RadaanK/Fischertechnik_Factory_IBM/int-connected-factory-master/Source_Code/Node_RED_Visual_Inspection/Readme_Images/Picture_of_Setup.jpg

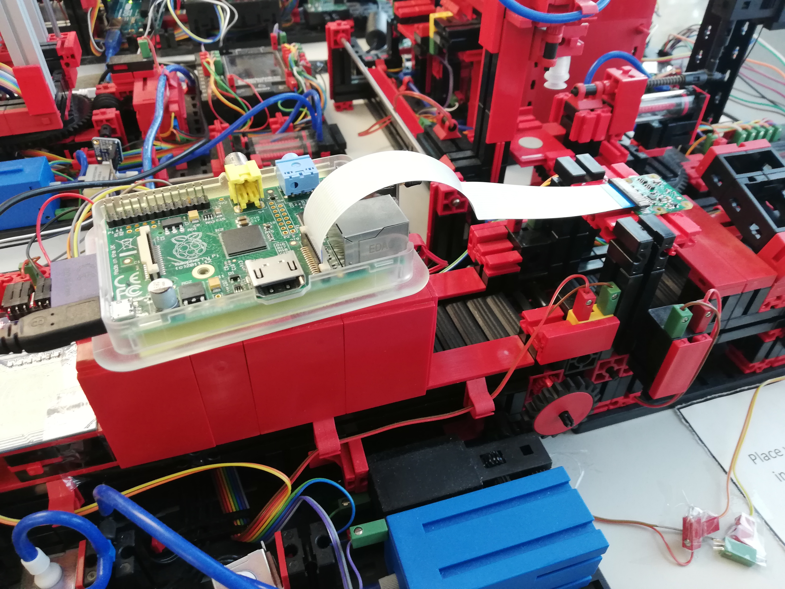
int-connected-factory-master/Source_Code/Node_RED_Visual_Inspection/Readme_Images/Picture_of_Setup.jpg
