RadaanK/Fischertechnik_Factory_IBM/int-connected-factory-master/Source_Code/Visual_Recognition/Images/Red_With_Scratch/pic_5ae9167f-bc9a-462e-9c37-ad97ae4d3c14.jpg

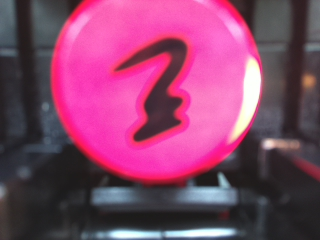
int-connected-factory-master/Source_Code/Visual_Recognition/Images/Red_With_Scratch/pic_5ae9167f-bc9a-462e-9c37-ad97ae4d3c14.jpg
