RadaanK/Fischertechnik_Factory_IBM/int-connected-factory-master/README.md

# Fischertechnik_Munich
This repo contains the code for the Fischertechnik plant at the 24th floor of the Munich IoT Centre.

# Foto
foto_of_plant
