RadaanK/Fischertechnik_Factory_IBM/int-connected-factory-master/Documents/Documents Fischertechnik/Readme.md

# Readme

This folder contains some documets about the different components delivered by Fischertechnik.
Some documents describe the used modules (warehouse, vaccum gripper, sorting line and processing station).
Others describe some individual parts (e.g. motor)
