RadaanK/Fischertechnik_Factory_IBM/int-connected-factory-master/Source_Code/Node_RED_Raspberry_Pi/Readme.md

# Readme

This folder contains the code for the Node-RED instance running on the Raspberry Pi 
(the one responible for the communication between the Arduinos and the IBM IoT platform).
First Node-RED has to be installed on the Raspberry Pi (https://nodered.org/docs/getting-started/raspberrypi).
Then the Json file can be imported as shown in the following picture: 
how_to_import
