RadaanK/Fischertechnik_Factory_IBM/int-connected-factory-master/Documents/QR_Code to access the Slack chatbot.docx

Get access to the chatbot in Slack:

- Search for “Fischertechnik Chatbot” in the GBS Watson IoT Practice Munich workspace
- Or scan this QR code:

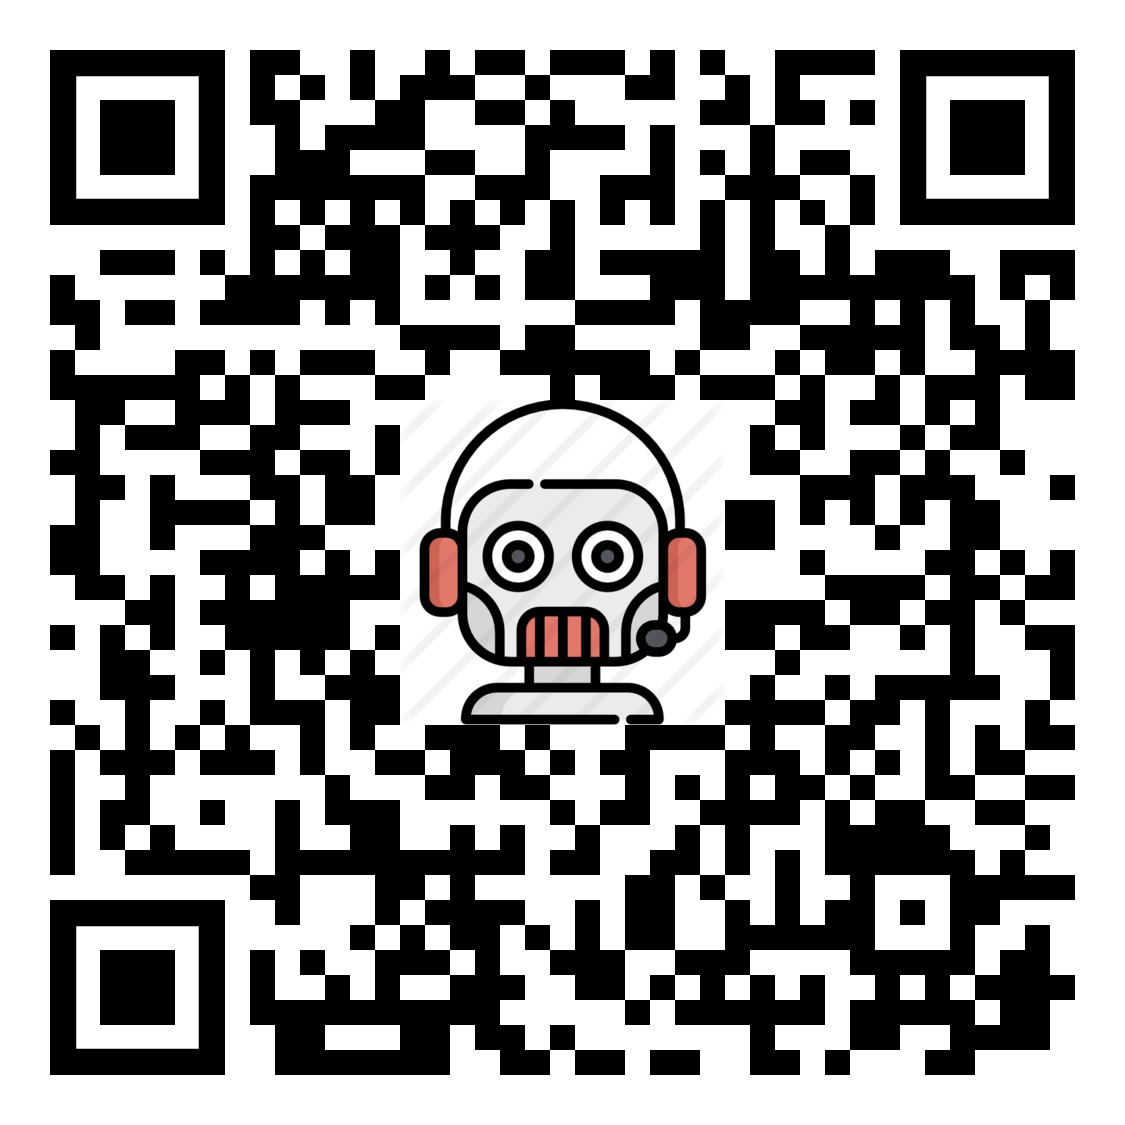
[picture p3: figure]
