RadaanK/Fischertechnik_Factory_IBM/int-connected-factory-master/Documents/Architecture/Architecture.png

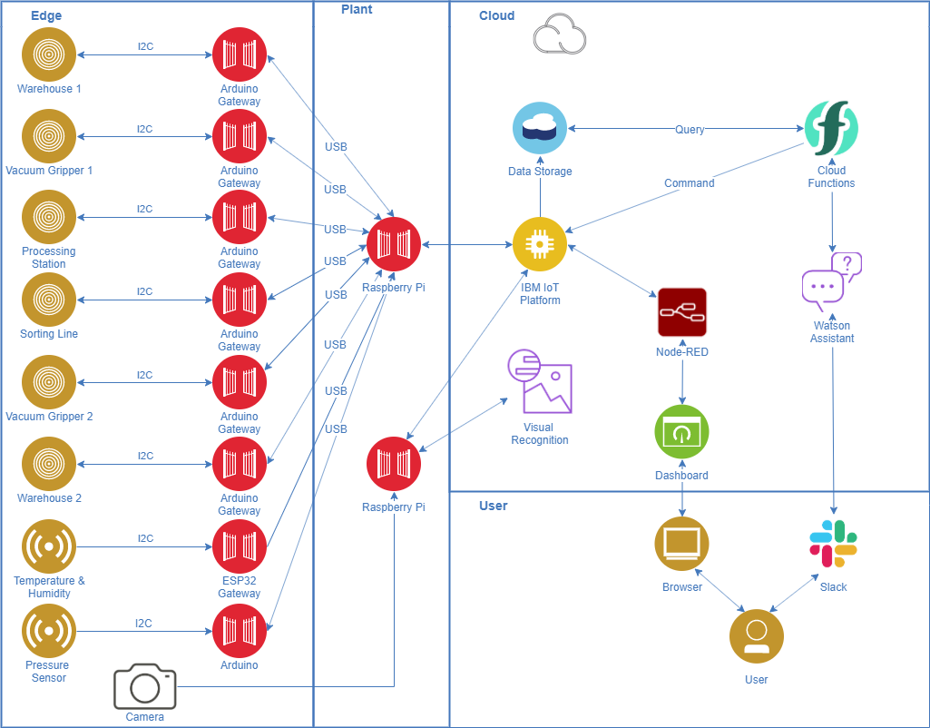
int-connected-factory-master/Documents/Architecture/Architecture.png
