RadaanK/Fischertechnik_Factory_IBM/int-connected-factory-master/Documents/Story/Story/IMG_20190731_112832.jpg

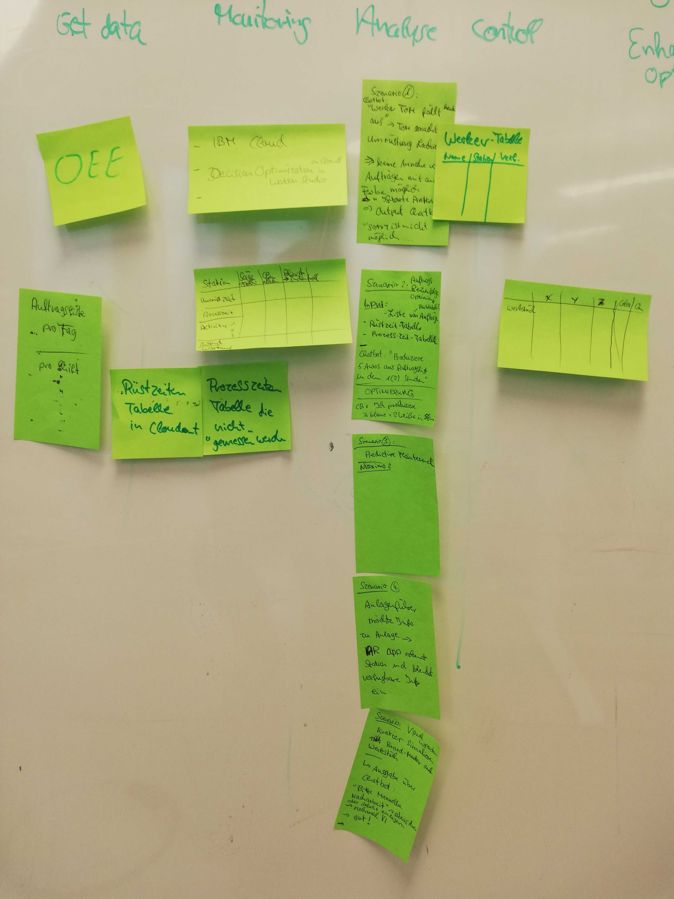
int-connected-factory-master/Documents/Story/Story/IMG_20190731_112832.jpg
