RadaanK/Fischertechnik_Factory_IBM/int-connected-factory-master/Documents/Story/Story/Scenarios/Szenario_5_Pressure_Sensor/Images/Figure 3.png

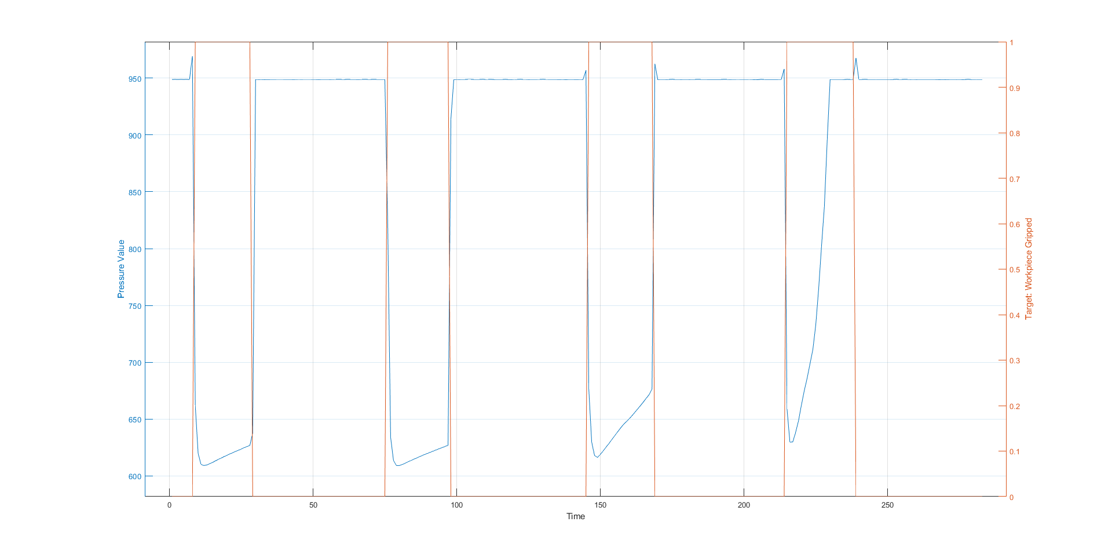
int-connected-factory-master/Documents/Story/Story/Scenarios/Szenario_5_Pressure_Sensor/Images/Figure 3.png
