RadaanK/Fischertechnik_Factory_IBM/int-connected-factory-master/Readme_Images/Foto_of_plant.jpg

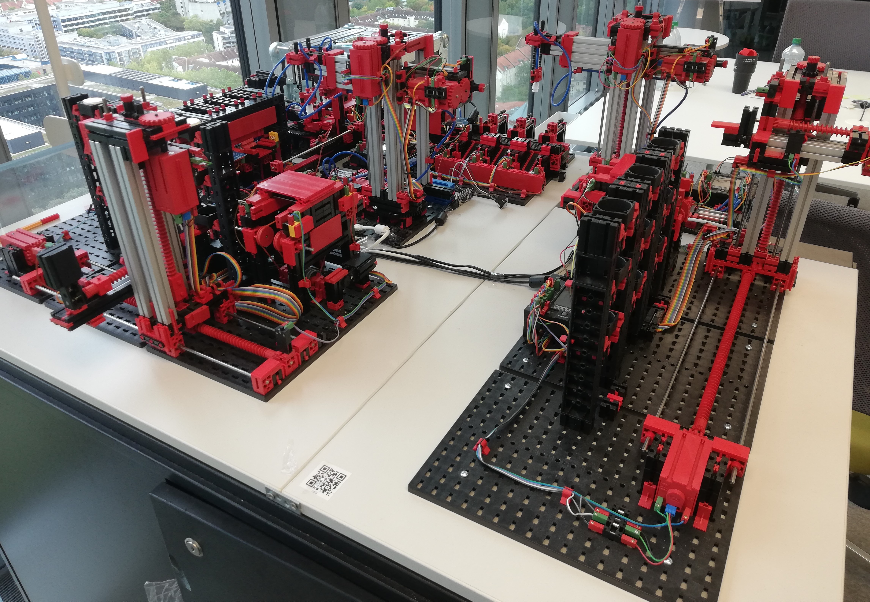
int-connected-factory-master/Readme_Images/Foto_of_plant.jpg
