RadaanK/Fischertechnik_Factory_IBM/int-connected-factory-master/Source_Code/Arduino/Readme_Images/Cabeling_Arduino_Uno.jpg

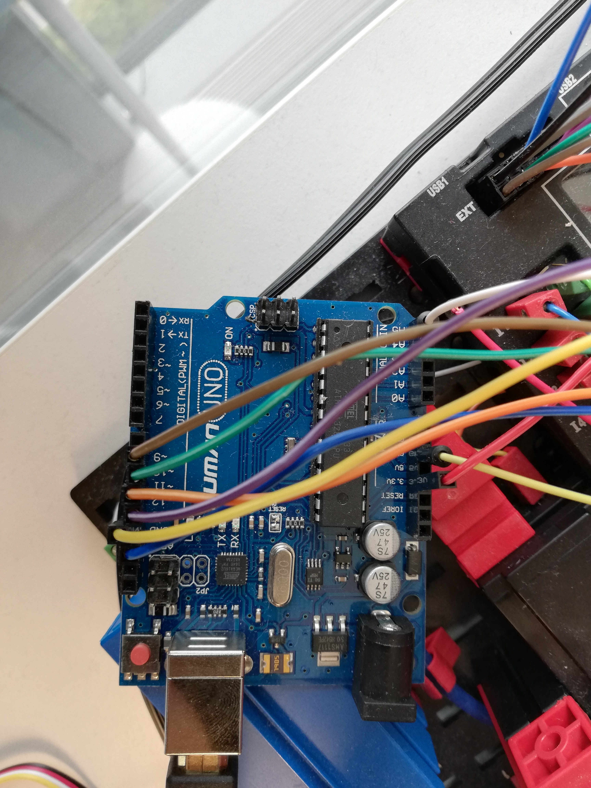
int-connected-factory-master/Source_Code/Arduino/Readme_Images/Cabeling_Arduino_Uno.jpg
