RadaanK/Fischertechnik_Factory_IBM/int-connected-factory-master/Source_Code/Arduino/Readme_Images/Cabeling_NFC_Reader.jpg

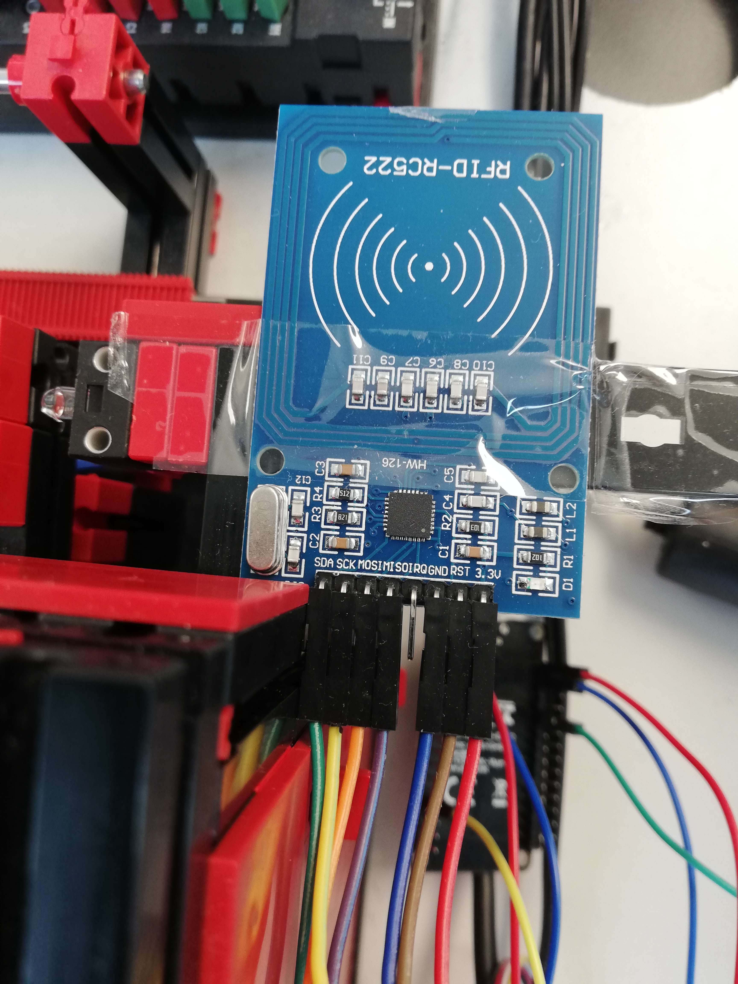
int-connected-factory-master/Source_Code/Arduino/Readme_Images/Cabeling_NFC_Reader.jpg
