RadaanK/Fischertechnik_Factory_IBM/int-connected-factory-master/Source_Code/Arduino/Readme_Images/Controller_Pin_Assignment.PNG

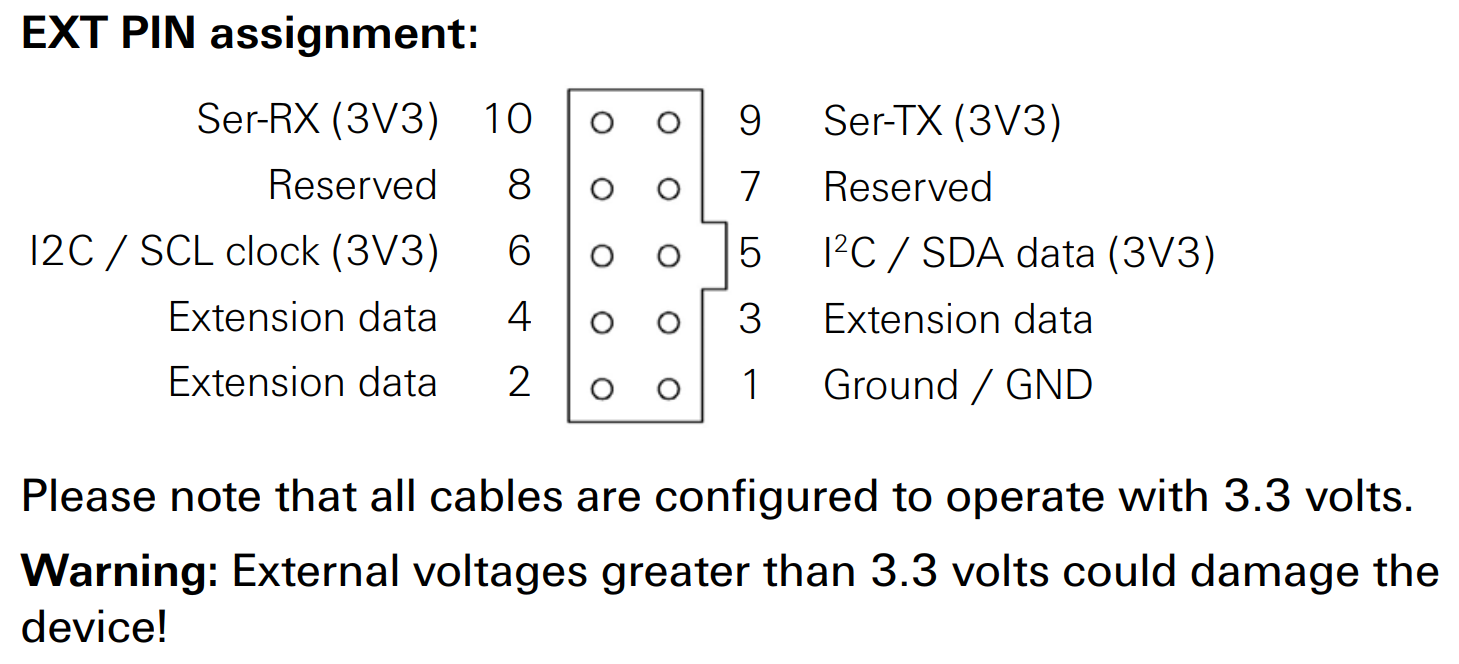
int-connected-factory-master/Source_Code/Arduino/Readme_Images/Controller_Pin_Assignment.PNG
