RadaanK/Fischertechnik_Factory_IBM/int-connected-factory-master/Source_Code/Cloud_Functions/Images_Readme/Cloud_Functions_1.png

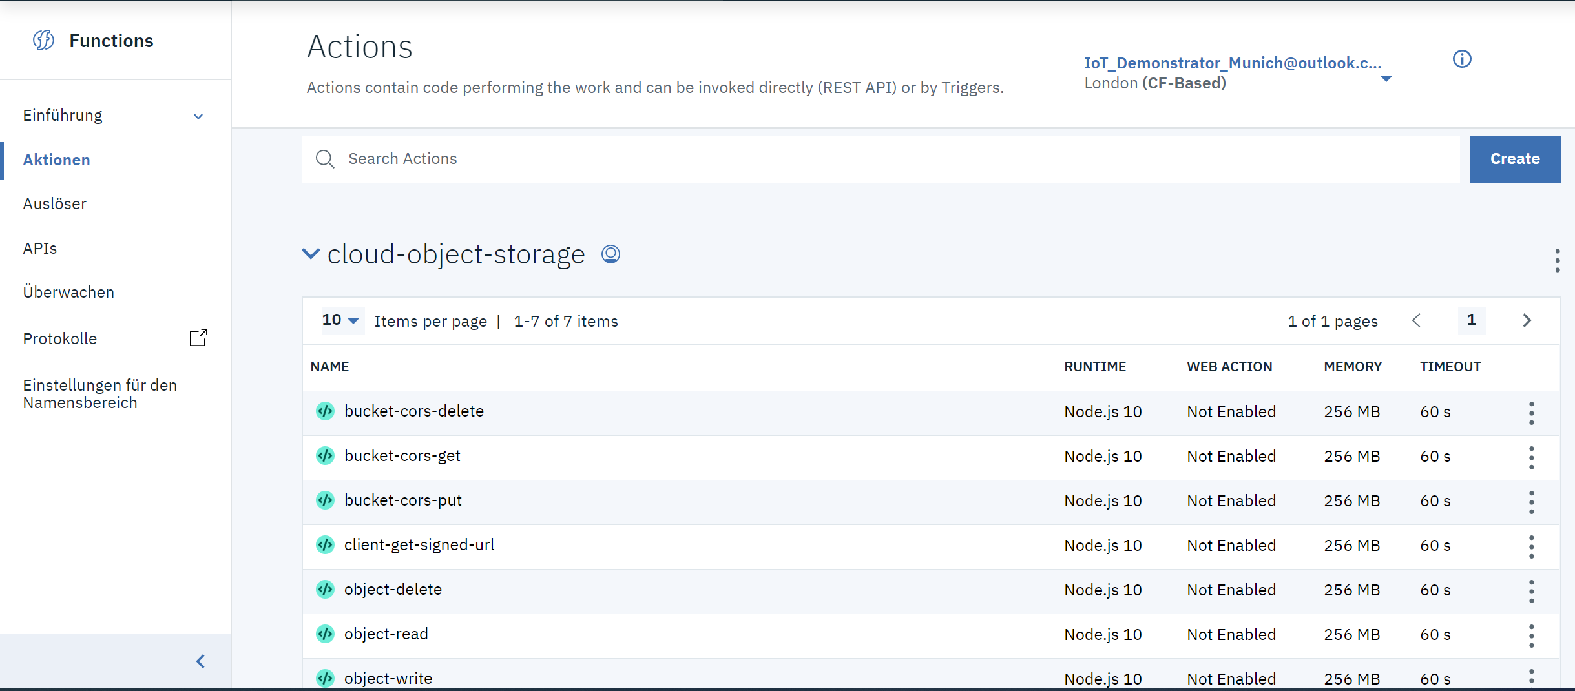
int-connected-factory-master/Source_Code/Cloud_Functions/Images_Readme/Cloud_Functions_1.png
