RadaanK/Fischertechnik_Factory_IBM/int-connected-factory-master/Source_Code/Visual_Recognition/Images/Blue_With_Scratch/pic_6ee05822-eb01-4ae4-a5b6-be8dfba36813.jpg

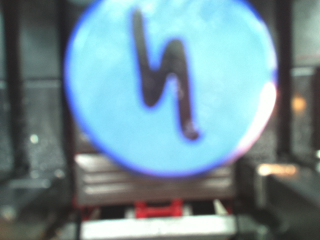
int-connected-factory-master/Source_Code/Visual_Recognition/Images/Blue_With_Scratch/pic_6ee05822-eb01-4ae4-a5b6-be8dfba36813.jpg
