RadaanK/Fischertechnik_Factory_IBM/int-connected-factory-master/Source_Code/Visual_Recognition/Images/Blue_With_Scratch/pic_44ba1a00-57a2-4b40-8c53-b260515f05a0.jpg

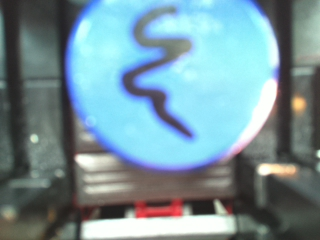
int-connected-factory-master/Source_Code/Visual_Recognition/Images/Blue_With_Scratch/pic_44ba1a00-57a2-4b40-8c53-b260515f05a0.jpg
