RadaanK/Fischertechnik_Factory_IBM/int-connected-factory-master/Source_Code/Visual_Recognition/Images/Blue_With_Scratch/pic_60d750b2-c480-4060-b84b-7900d25849db.jpg

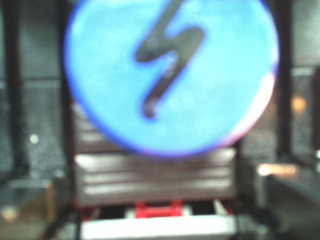
int-connected-factory-master/Source_Code/Visual_Recognition/Images/Blue_With_Scratch/pic_60d750b2-c480-4060-b84b-7900d25849db.jpg
