RadaanK/Fischertechnik_Factory_IBM/int-connected-factory-master/Source_Code/Visual_Recognition/Images/Blue_With_Scratch/pic_257f01ea-9b48-4399-9710-3b7ceee71c3d.jpg

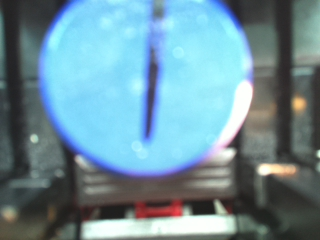
int-connected-factory-master/Source_Code/Visual_Recognition/Images/Blue_With_Scratch/pic_257f01ea-9b48-4399-9710-3b7ceee71c3d.jpg
