RadaanK/Fischertechnik_Factory_IBM/int-connected-factory-master/Source_Code/Visual_Recognition/Images/Blue_With_Scratch/pic_585baca4-2b5c-4661-a3ae-9914493b79fe.jpg

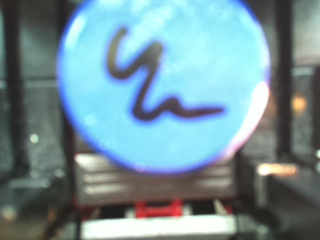
int-connected-factory-master/Source_Code/Visual_Recognition/Images/Blue_With_Scratch/pic_585baca4-2b5c-4661-a3ae-9914493b79fe.jpg
