RadaanK/Fischertechnik_Factory_IBM/int-connected-factory-master/Source_Code/Visual_Recognition/Images/Blue_With_Scratch/pic_4958c0a8-0177-4b15-a33d-297569485a4a.jpg

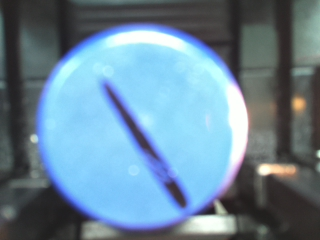
int-connected-factory-master/Source_Code/Visual_Recognition/Images/Blue_With_Scratch/pic_4958c0a8-0177-4b15-a33d-297569485a4a.jpg
