RadaanK/Fischertechnik_Factory_IBM/int-connected-factory-master/Source_Code/Visual_Recognition/Images/Blue_With_Scratch/pic_7865c3a0-ef06-42df-8c5a-3ec4aaaf4b60.jpg

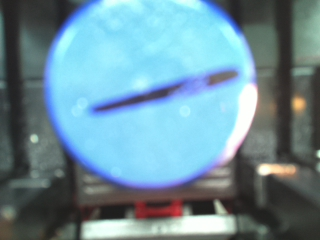
int-connected-factory-master/Source_Code/Visual_Recognition/Images/Blue_With_Scratch/pic_7865c3a0-ef06-42df-8c5a-3ec4aaaf4b60.jpg
