RadaanK/Fischertechnik_Factory_IBM/int-connected-factory-master/Source_Code/Visual_Recognition/Images/Blue_With_Scratch/pic_92756736-0fad-4278-b8e0-99494414e42e.jpg

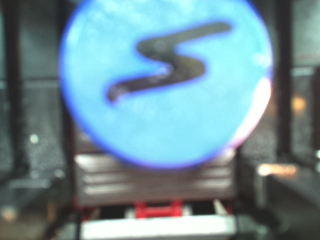
int-connected-factory-master/Source_Code/Visual_Recognition/Images/Blue_With_Scratch/pic_92756736-0fad-4278-b8e0-99494414e42e.jpg
