RadaanK/Fischertechnik_Factory_IBM/int-connected-factory-master/Source_Code/Visual_Recognition/Images/Blue_With_Scratch/pic_a7a9ee02-e9d2-4ce0-b42a-490beab9bbe5.jpg

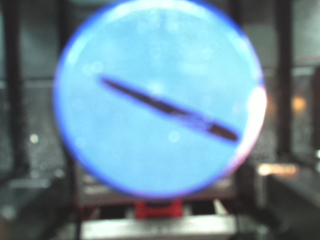
int-connected-factory-master/Source_Code/Visual_Recognition/Images/Blue_With_Scratch/pic_a7a9ee02-e9d2-4ce0-b42a-490beab9bbe5.jpg
