RadaanK/Fischertechnik_Factory_IBM/int-connected-factory-master/Source_Code/Visual_Recognition/Images/Blue_With_Scratch/pic_bf9dd142-1b95-439f-b088-64bb233a1e68.jpg

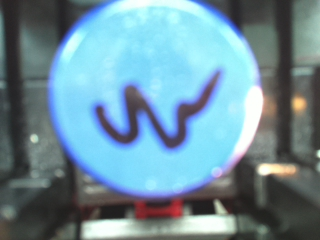
int-connected-factory-master/Source_Code/Visual_Recognition/Images/Blue_With_Scratch/pic_bf9dd142-1b95-439f-b088-64bb233a1e68.jpg
