RadaanK/Fischertechnik_Factory_IBM/int-connected-factory-master/Source_Code/Visual_Recognition/Images/Blue_With_Scratch/pic_d63db4d3-26aa-41d6-b190-c1351fe853c5.jpg

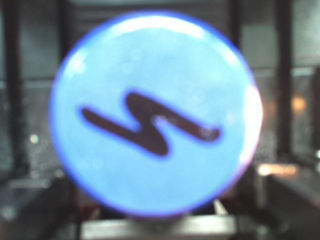
int-connected-factory-master/Source_Code/Visual_Recognition/Images/Blue_With_Scratch/pic_d63db4d3-26aa-41d6-b190-c1351fe853c5.jpg
