RadaanK/Fischertechnik_Factory_IBM/int-connected-factory-master/Source_Code/Visual_Recognition/Images/Blue_With_Scratch/pic_f52674f7-41e7-4f9a-8e8a-8ba461ca570b.jpg

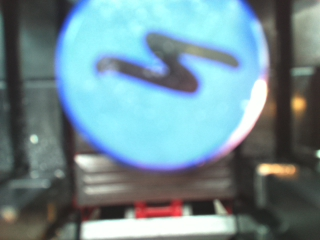
int-connected-factory-master/Source_Code/Visual_Recognition/Images/Blue_With_Scratch/pic_f52674f7-41e7-4f9a-8e8a-8ba461ca570b.jpg
