RadaanK/Fischertechnik_Factory_IBM/int-connected-factory-master/Source_Code/Visual_Recognition/Images/Blue_With_Scratch/pic_ff827206-aa92-4c91-befb-8f4d27b9cf81.jpg

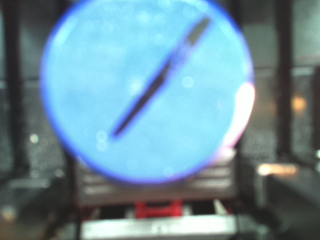
int-connected-factory-master/Source_Code/Visual_Recognition/Images/Blue_With_Scratch/pic_ff827206-aa92-4c91-befb-8f4d27b9cf81.jpg
