RadaanK/Fischertechnik_Factory_IBM/int-connected-factory-master/Source_Code/Visual_Recognition/Images/Blue_Without_Scratch/pic_2bd5c420-6e2a-474f-995c-3f01320a25c1.jpg

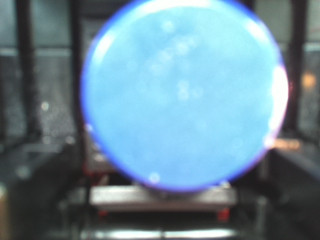
int-connected-factory-master/Source_Code/Visual_Recognition/Images/Blue_Without_Scratch/pic_2bd5c420-6e2a-474f-995c-3f01320a25c1.jpg
