RadaanK/Fischertechnik_Factory_IBM/int-connected-factory-master/Source_Code/Visual_Recognition/Images/Blue_Without_Scratch/pic_03bd9a95-2f23-43ee-b81c-bd671a089540.jpg

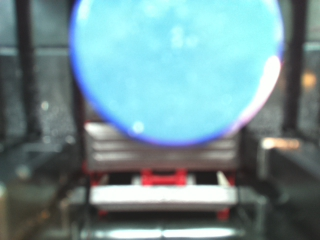
int-connected-factory-master/Source_Code/Visual_Recognition/Images/Blue_Without_Scratch/pic_03bd9a95-2f23-43ee-b81c-bd671a089540.jpg
