RadaanK/Fischertechnik_Factory_IBM/int-connected-factory-master/Source_Code/Visual_Recognition/Images/Blue_Without_Scratch/pic_6b2f1941-4130-4e85-a551-bb04257c04fe.jpg

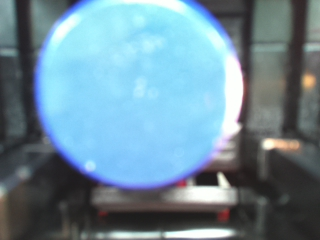
int-connected-factory-master/Source_Code/Visual_Recognition/Images/Blue_Without_Scratch/pic_6b2f1941-4130-4e85-a551-bb04257c04fe.jpg
