RadaanK/Fischertechnik_Factory_IBM/int-connected-factory-master/Source_Code/Visual_Recognition/Images/Blue_Without_Scratch/pic_8d54d213-2766-4aaa-8784-aa275ecdaccd.jpg

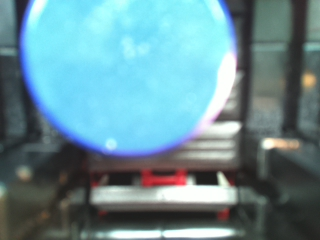
int-connected-factory-master/Source_Code/Visual_Recognition/Images/Blue_Without_Scratch/pic_8d54d213-2766-4aaa-8784-aa275ecdaccd.jpg
