RadaanK/Fischertechnik_Factory_IBM/int-connected-factory-master/Source_Code/Visual_Recognition/Images/Blue_Without_Scratch/pic_16edd78b-cffc-4e18-be51-fe0cdaa5b705.jpg

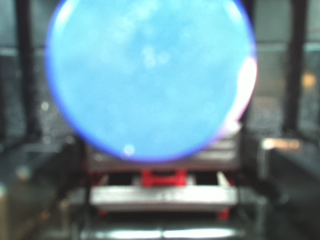
int-connected-factory-master/Source_Code/Visual_Recognition/Images/Blue_Without_Scratch/pic_16edd78b-cffc-4e18-be51-fe0cdaa5b705.jpg
