RadaanK/Fischertechnik_Factory_IBM/int-connected-factory-master/Source_Code/Visual_Recognition/Images/Blue_Without_Scratch/pic_100e419a-90d1-41c0-990e-5b7522d13269.jpg

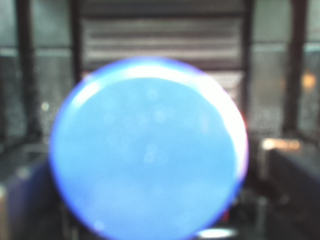
int-connected-factory-master/Source_Code/Visual_Recognition/Images/Blue_Without_Scratch/pic_100e419a-90d1-41c0-990e-5b7522d13269.jpg
