RadaanK/Fischertechnik_Factory_IBM/int-connected-factory-master/Source_Code/Visual_Recognition/Images/Blue_Without_Scratch/pic_443fc9e2-942e-4b88-b6fd-92f85d25942b.jpg

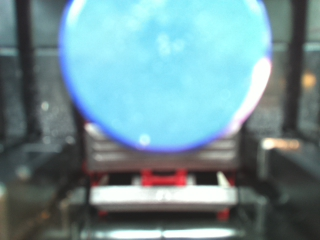
int-connected-factory-master/Source_Code/Visual_Recognition/Images/Blue_Without_Scratch/pic_443fc9e2-942e-4b88-b6fd-92f85d25942b.jpg
