RadaanK/Fischertechnik_Factory_IBM/int-connected-factory-master/Source_Code/Visual_Recognition/Images/Blue_Without_Scratch/pic_a1e88f21-aa5b-4406-b35d-a229cc25c989.jpg

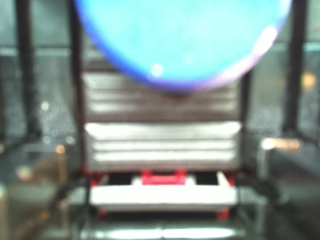
int-connected-factory-master/Source_Code/Visual_Recognition/Images/Blue_Without_Scratch/pic_a1e88f21-aa5b-4406-b35d-a229cc25c989.jpg
