RadaanK/Fischertechnik_Factory_IBM/int-connected-factory-master/Source_Code/Visual_Recognition/Images/Blue_Without_Scratch/pic_c731b44b-4198-4752-98b8-99e775d03f8e.jpg

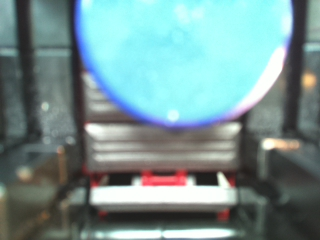
int-connected-factory-master/Source_Code/Visual_Recognition/Images/Blue_Without_Scratch/pic_c731b44b-4198-4752-98b8-99e775d03f8e.jpg
