RadaanK/Fischertechnik_Factory_IBM/int-connected-factory-master/Source_Code/Visual_Recognition/Images/Blue_Without_Scratch/pic_f74e6497-be4d-4806-879b-3bc070af202e.jpg

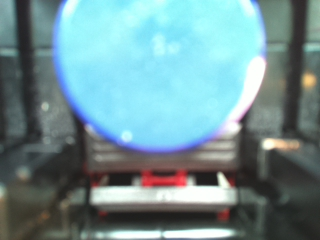
int-connected-factory-master/Source_Code/Visual_Recognition/Images/Blue_Without_Scratch/pic_f74e6497-be4d-4806-879b-3bc070af202e.jpg
