RadaanK/Fischertechnik_Factory_IBM/int-connected-factory-master/Source_Code/Visual_Recognition/Images/No_Workpiece/pic_7c79bbad-e781-4910-84c2-cd3412517aed.jpg

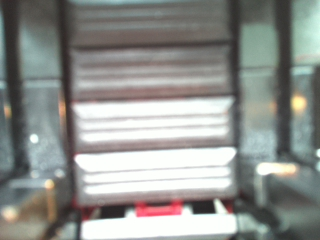
int-connected-factory-master/Source_Code/Visual_Recognition/Images/No_Workpiece/pic_7c79bbad-e781-4910-84c2-cd3412517aed.jpg
