RadaanK/Fischertechnik_Factory_IBM/int-connected-factory-master/Source_Code/Visual_Recognition/Images/No_Workpiece/pic_5428665c-1ac8-4c36-be89-cd5b3be53e2c.jpg

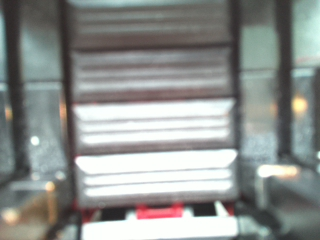
int-connected-factory-master/Source_Code/Visual_Recognition/Images/No_Workpiece/pic_5428665c-1ac8-4c36-be89-cd5b3be53e2c.jpg
