RadaanK/Fischertechnik_Factory_IBM/int-connected-factory-master/Source_Code/Visual_Recognition/Images/No_Workpiece/pic_43159170-60e4-4133-8779-5aea9031d7ec.jpg

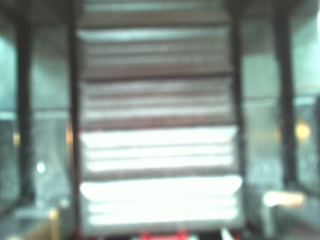
int-connected-factory-master/Source_Code/Visual_Recognition/Images/No_Workpiece/pic_43159170-60e4-4133-8779-5aea9031d7ec.jpg
