RadaanK/Fischertechnik_Factory_IBM/int-connected-factory-master/Source_Code/Visual_Recognition/Images/Red_With_Scratch/pic_1fc5a1ba-6591-4306-b836-01b4095cde05.jpg

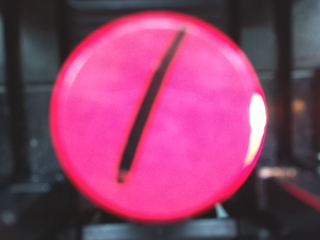
int-connected-factory-master/Source_Code/Visual_Recognition/Images/Red_With_Scratch/pic_1fc5a1ba-6591-4306-b836-01b4095cde05.jpg
