RadaanK/Fischertechnik_Factory_IBM/int-connected-factory-master/Source_Code/Visual_Recognition/Images/Red_With_Scratch/pic_6c0c605b-86db-4a4c-b3e3-3497d2ecde54.jpg

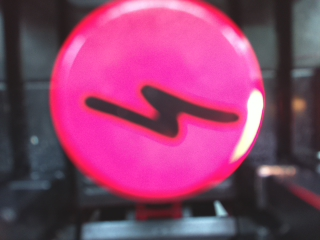
int-connected-factory-master/Source_Code/Visual_Recognition/Images/Red_With_Scratch/pic_6c0c605b-86db-4a4c-b3e3-3497d2ecde54.jpg
