RadaanK/Fischertechnik_Factory_IBM/int-connected-factory-master/Source_Code/Visual_Recognition/Images/Red_With_Scratch/pic_49e84ed8-d9ab-4422-9b6c-5a36736f64b0.jpg

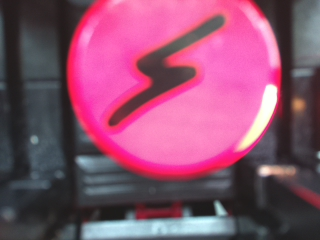
int-connected-factory-master/Source_Code/Visual_Recognition/Images/Red_With_Scratch/pic_49e84ed8-d9ab-4422-9b6c-5a36736f64b0.jpg
