RadaanK/Fischertechnik_Factory_IBM/int-connected-factory-master/Source_Code/Visual_Recognition/Images/Red_With_Scratch/pic_902d0cdd-8ce4-48a2-b398-864d60b77477.jpg

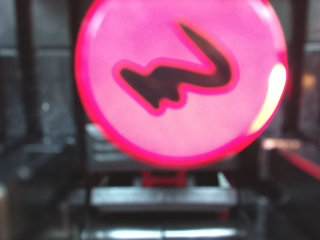
int-connected-factory-master/Source_Code/Visual_Recognition/Images/Red_With_Scratch/pic_902d0cdd-8ce4-48a2-b398-864d60b77477.jpg
