RadaanK/Fischertechnik_Factory_IBM/int-connected-factory-master/Source_Code/Visual_Recognition/Images/Red_With_Scratch/pic_912b4482-c928-4562-92a2-9c388088ef4c.jpg

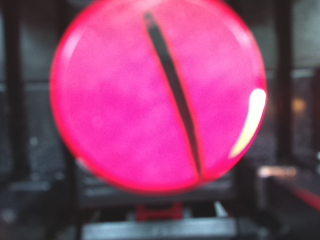
int-connected-factory-master/Source_Code/Visual_Recognition/Images/Red_With_Scratch/pic_912b4482-c928-4562-92a2-9c388088ef4c.jpg
