RadaanK/Fischertechnik_Factory_IBM/int-connected-factory-master/Source_Code/Visual_Recognition/Images/Red_With_Scratch/pic_966dfb1d-3ee6-43b8-9916-991be9dda959.jpg

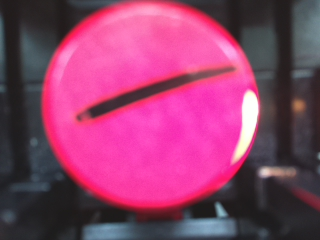
int-connected-factory-master/Source_Code/Visual_Recognition/Images/Red_With_Scratch/pic_966dfb1d-3ee6-43b8-9916-991be9dda959.jpg
