RadaanK/Fischertechnik_Factory_IBM/int-connected-factory-master/Source_Code/Visual_Recognition/Images/Red_With_Scratch/pic_2315ad4b-5ecf-494b-81a8-4649002291f0.jpg

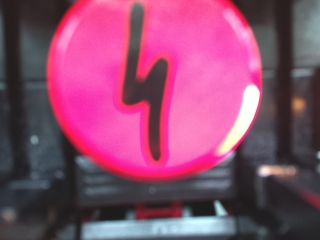
int-connected-factory-master/Source_Code/Visual_Recognition/Images/Red_With_Scratch/pic_2315ad4b-5ecf-494b-81a8-4649002291f0.jpg
