RadaanK/Fischertechnik_Factory_IBM/int-connected-factory-master/Source_Code/Visual_Recognition/Images/Red_With_Scratch/pic_7496dad8-e732-4b92-aa2e-0782ee8b002e.jpg

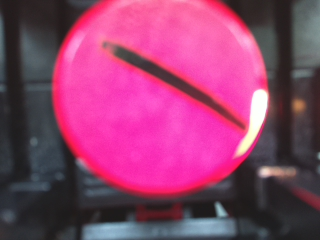
int-connected-factory-master/Source_Code/Visual_Recognition/Images/Red_With_Scratch/pic_7496dad8-e732-4b92-aa2e-0782ee8b002e.jpg
