RadaanK/Fischertechnik_Factory_IBM/int-connected-factory-master/Source_Code/Visual_Recognition/Images/Red_With_Scratch/pic_159555d0-30fc-4e93-9c4b-e4c3b19fbac0.jpg

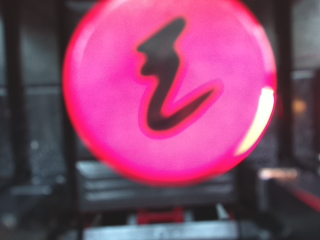
int-connected-factory-master/Source_Code/Visual_Recognition/Images/Red_With_Scratch/pic_159555d0-30fc-4e93-9c4b-e4c3b19fbac0.jpg
