RadaanK/Fischertechnik_Factory_IBM/int-connected-factory-master/Source_Code/Visual_Recognition/Images/Red_With_Scratch/pic_a941a2e0-b87a-4e30-942a-0a5fac9722af.jpg

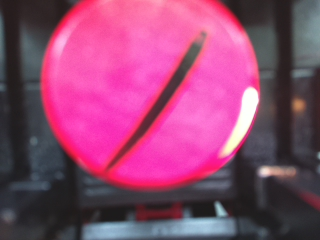
int-connected-factory-master/Source_Code/Visual_Recognition/Images/Red_With_Scratch/pic_a941a2e0-b87a-4e30-942a-0a5fac9722af.jpg
