RadaanK/Fischertechnik_Factory_IBM/int-connected-factory-master/Source_Code/Visual_Recognition/Images/Red_With_Scratch/pic_e6fc505e-8fb1-4975-84c8-51584e118ead.jpg

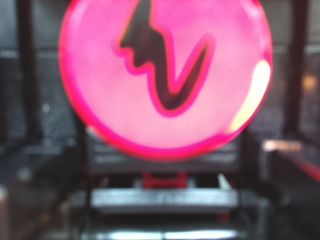
int-connected-factory-master/Source_Code/Visual_Recognition/Images/Red_With_Scratch/pic_e6fc505e-8fb1-4975-84c8-51584e118ead.jpg
