RadaanK/Fischertechnik_Factory_IBM/int-connected-factory-master/Source_Code/Visual_Recognition/Images/Red_With_Scratch/pic_f9133105-80e1-4a96-8cf9-9a1a2191820e.jpg

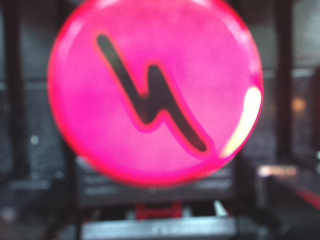
int-connected-factory-master/Source_Code/Visual_Recognition/Images/Red_With_Scratch/pic_f9133105-80e1-4a96-8cf9-9a1a2191820e.jpg
