RadaanK/Fischertechnik_Factory_IBM/int-connected-factory-master/Source_Code/Visual_Recognition/Images/Red_With_Scratch/pic_fe8fce01-5d8d-494c-98e0-f4d57ea840aa.jpg

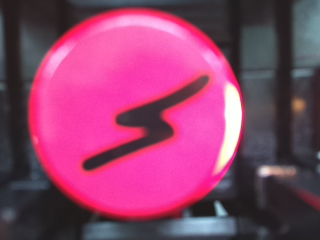
int-connected-factory-master/Source_Code/Visual_Recognition/Images/Red_With_Scratch/pic_fe8fce01-5d8d-494c-98e0-f4d57ea840aa.jpg
