RadaanK/Fischertechnik_Factory_IBM/int-connected-factory-master/Source_Code/Visual_Recognition/Images/Red_Without_Scratch/pic_3f4c9419-3676-4ad7-bed3-490422fa68b0.jpg

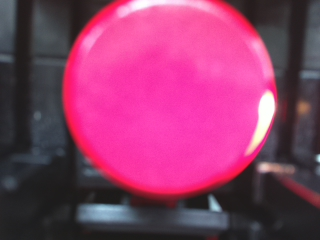
int-connected-factory-master/Source_Code/Visual_Recognition/Images/Red_Without_Scratch/pic_3f4c9419-3676-4ad7-bed3-490422fa68b0.jpg
