RadaanK/Fischertechnik_Factory_IBM/int-connected-factory-master/Source_Code/Visual_Recognition/Images/Red_Without_Scratch/pic_7ddf3377-bf2f-4b33-bc89-32006f9bbcb6.jpg

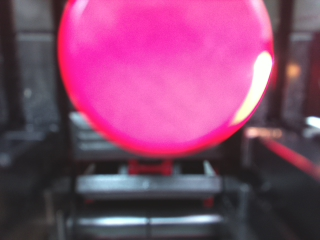
int-connected-factory-master/Source_Code/Visual_Recognition/Images/Red_Without_Scratch/pic_7ddf3377-bf2f-4b33-bc89-32006f9bbcb6.jpg
