RadaanK/Fischertechnik_Factory_IBM/int-connected-factory-master/Source_Code/Visual_Recognition/Images/Red_Without_Scratch/pic_39f35ca6-edfc-4342-aa67-f908ff8c4f34.jpg

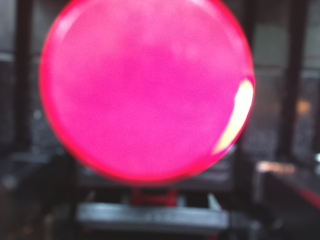
int-connected-factory-master/Source_Code/Visual_Recognition/Images/Red_Without_Scratch/pic_39f35ca6-edfc-4342-aa67-f908ff8c4f34.jpg
