RadaanK/Fischertechnik_Factory_IBM/int-connected-factory-master/Source_Code/Visual_Recognition/Images/Red_Without_Scratch/pic_43e07946-334a-4f09-98af-b26126dc2bfa.jpg

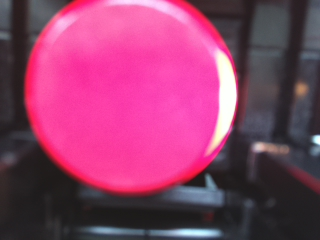
int-connected-factory-master/Source_Code/Visual_Recognition/Images/Red_Without_Scratch/pic_43e07946-334a-4f09-98af-b26126dc2bfa.jpg
