RadaanK/Fischertechnik_Factory_IBM/int-connected-factory-master/Source_Code/Visual_Recognition/Images/Red_Without_Scratch/pic_697b8a58-b791-4c87-b71b-28c6c0a0b243.jpg

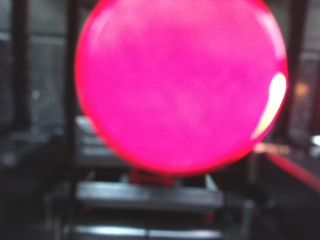
int-connected-factory-master/Source_Code/Visual_Recognition/Images/Red_Without_Scratch/pic_697b8a58-b791-4c87-b71b-28c6c0a0b243.jpg
