RadaanK/Fischertechnik_Factory_IBM/int-connected-factory-master/Source_Code/Visual_Recognition/Images/Red_Without_Scratch/pic_844e306a-b8a1-42a3-9f50-3c7844aba107.jpg

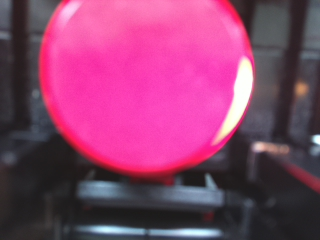
int-connected-factory-master/Source_Code/Visual_Recognition/Images/Red_Without_Scratch/pic_844e306a-b8a1-42a3-9f50-3c7844aba107.jpg
