RadaanK/Fischertechnik_Factory_IBM/int-connected-factory-master/Source_Code/Visual_Recognition/Images/Red_Without_Scratch/pic_8365be19-f5ab-44b7-96f6-f3c2adcea7c7.jpg

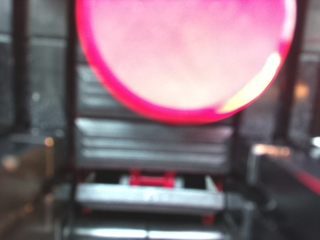
int-connected-factory-master/Source_Code/Visual_Recognition/Images/Red_Without_Scratch/pic_8365be19-f5ab-44b7-96f6-f3c2adcea7c7.jpg
