RadaanK/Fischertechnik_Factory_IBM/int-connected-factory-master/Source_Code/Visual_Recognition/Images/Red_Without_Scratch/pic_987458ea-8552-498f-9b6d-43d805b4d779.jpg

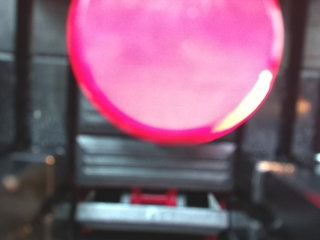
int-connected-factory-master/Source_Code/Visual_Recognition/Images/Red_Without_Scratch/pic_987458ea-8552-498f-9b6d-43d805b4d779.jpg
