RadaanK/Fischertechnik_Factory_IBM/int-connected-factory-master/Source_Code/Visual_Recognition/Images/Red_Without_Scratch/pic_bb30e531-f256-4c5e-8491-cca4f9ee8381.jpg

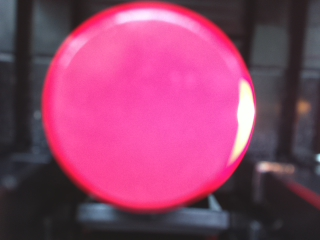
int-connected-factory-master/Source_Code/Visual_Recognition/Images/Red_Without_Scratch/pic_bb30e531-f256-4c5e-8491-cca4f9ee8381.jpg
