RadaanK/Fischertechnik_Factory_IBM/int-connected-factory-master/Source_Code/Visual_Recognition/Images/Red_Without_Scratch/pic_cc872f9e-1a1a-4c94-ba2b-3b65df1353e3.jpg

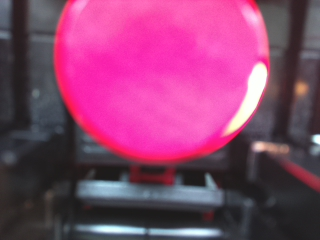
int-connected-factory-master/Source_Code/Visual_Recognition/Images/Red_Without_Scratch/pic_cc872f9e-1a1a-4c94-ba2b-3b65df1353e3.jpg
