RadaanK/Fischertechnik_Factory_IBM/int-connected-factory-master/Source_Code/Visual_Recognition/Images/White_With_Scratch/pic_1eed80d7-723c-4dd2-90a6-a59df02e2cea.jpg

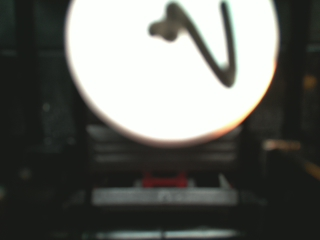
int-connected-factory-master/Source_Code/Visual_Recognition/Images/White_With_Scratch/pic_1eed80d7-723c-4dd2-90a6-a59df02e2cea.jpg
