RadaanK/Fischertechnik_Factory_IBM/int-connected-factory-master/Source_Code/Visual_Recognition/Images/White_With_Scratch/pic_8b900f87-ac96-48c1-853b-e7016e9b47be.jpg

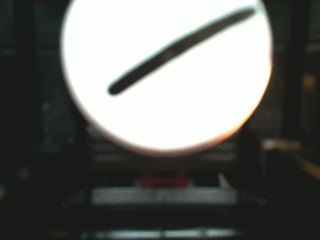
int-connected-factory-master/Source_Code/Visual_Recognition/Images/White_With_Scratch/pic_8b900f87-ac96-48c1-853b-e7016e9b47be.jpg
