RadaanK/Fischertechnik_Factory_IBM/int-connected-factory-master/Source_Code/Visual_Recognition/Images/White_With_Scratch/pic_240ef28a-73b6-4027-ac60-659986fd7b0c.jpg

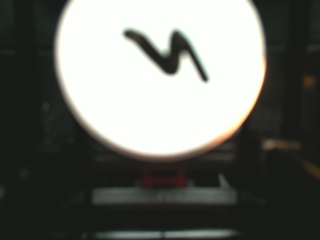
int-connected-factory-master/Source_Code/Visual_Recognition/Images/White_With_Scratch/pic_240ef28a-73b6-4027-ac60-659986fd7b0c.jpg
