RadaanK/Fischertechnik_Factory_IBM/int-connected-factory-master/Source_Code/Visual_Recognition/Images/White_With_Scratch/pic_ac5ccc3d-852a-49ae-a590-8647746be012.jpg

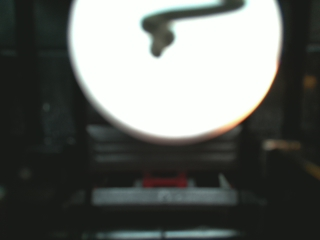
int-connected-factory-master/Source_Code/Visual_Recognition/Images/White_With_Scratch/pic_ac5ccc3d-852a-49ae-a590-8647746be012.jpg
