RadaanK/Fischertechnik_Factory_IBM/int-connected-factory-master/Source_Code/Visual_Recognition/Images/White_With_Scratch/pic_c37bdcb0-db98-4761-9ebe-55499684d6a7.jpg

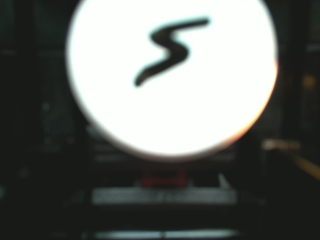
int-connected-factory-master/Source_Code/Visual_Recognition/Images/White_With_Scratch/pic_c37bdcb0-db98-4761-9ebe-55499684d6a7.jpg
