RadaanK/Fischertechnik_Factory_IBM/int-connected-factory-master/Source_Code/Visual_Recognition/Images/White_With_Scratch/pic_c1540c4d-9c05-4147-a8b8-e87be852c95c.jpg

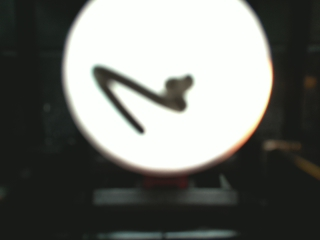
int-connected-factory-master/Source_Code/Visual_Recognition/Images/White_With_Scratch/pic_c1540c4d-9c05-4147-a8b8-e87be852c95c.jpg
