RadaanK/Fischertechnik_Factory_IBM/int-connected-factory-master/Source_Code/Visual_Recognition/Images/White_With_Scratch/pic_d27f8e91-5098-4c3b-b112-4150da29beca.jpg

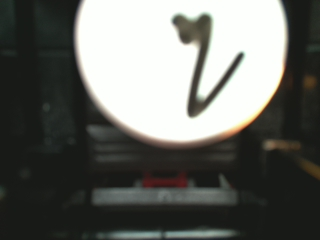
int-connected-factory-master/Source_Code/Visual_Recognition/Images/White_With_Scratch/pic_d27f8e91-5098-4c3b-b112-4150da29beca.jpg
