RadaanK/Fischertechnik_Factory_IBM/int-connected-factory-master/Source_Code/Visual_Recognition/Images/White_With_Scratch/pic_da950a07-f7db-473d-9e92-025bf4d4c894.jpg

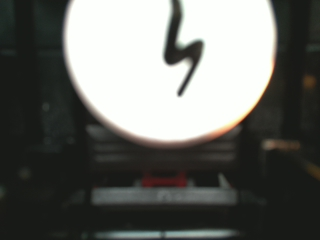
int-connected-factory-master/Source_Code/Visual_Recognition/Images/White_With_Scratch/pic_da950a07-f7db-473d-9e92-025bf4d4c894.jpg
