RadaanK/Fischertechnik_Factory_IBM/int-connected-factory-master/Source_Code/Visual_Recognition/Images/White_With_Scratch/pic_f9fa90cf-81bd-4dd5-bda9-a9af8b7e6f8b.jpg

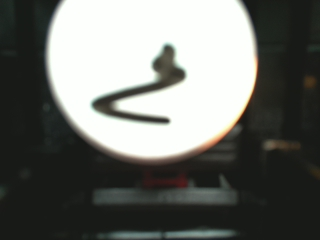
int-connected-factory-master/Source_Code/Visual_Recognition/Images/White_With_Scratch/pic_f9fa90cf-81bd-4dd5-bda9-a9af8b7e6f8b.jpg
