RadaanK/Fischertechnik_Factory_IBM/int-connected-factory-master/Source_Code/Visual_Recognition/Images/White_Without_Scratch/pic_1cdd5dcb-5c03-409a-ab07-2e535f10d59e.jpg

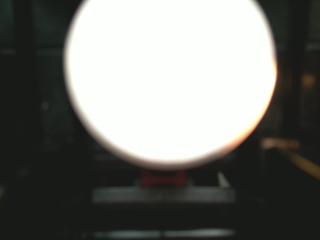
int-connected-factory-master/Source_Code/Visual_Recognition/Images/White_Without_Scratch/pic_1cdd5dcb-5c03-409a-ab07-2e535f10d59e.jpg
