RadaanK/Fischertechnik_Factory_IBM/int-connected-factory-master/Source_Code/Visual_Recognition/Images/White_Without_Scratch/pic_2a2fdcee-0563-4ec3-8249-298d67692e07.jpg

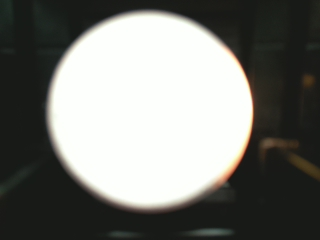
int-connected-factory-master/Source_Code/Visual_Recognition/Images/White_Without_Scratch/pic_2a2fdcee-0563-4ec3-8249-298d67692e07.jpg
