RadaanK/Fischertechnik_Factory_IBM/int-connected-factory-master/Source_Code/Visual_Recognition/Images/White_Without_Scratch/pic_5e7baaff-5c89-47b9-98fe-b09d06673c36.jpg

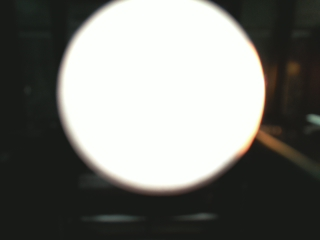
int-connected-factory-master/Source_Code/Visual_Recognition/Images/White_Without_Scratch/pic_5e7baaff-5c89-47b9-98fe-b09d06673c36.jpg
