RadaanK/Fischertechnik_Factory_IBM/int-connected-factory-master/Source_Code/Visual_Recognition/Images/White_Without_Scratch/pic_215fbd3c-237d-4bd7-b5fc-53642530fbd0.jpg

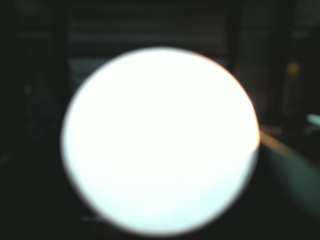
int-connected-factory-master/Source_Code/Visual_Recognition/Images/White_Without_Scratch/pic_215fbd3c-237d-4bd7-b5fc-53642530fbd0.jpg
