RadaanK/Fischertechnik_Factory_IBM/int-connected-factory-master/Source_Code/Visual_Recognition/Images/White_Without_Scratch/pic_7539ce21-5394-4477-a6c9-f5aeb3b18424.jpg

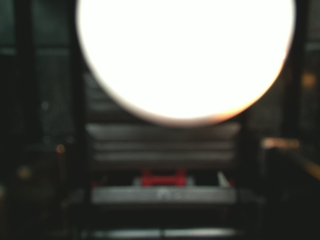
int-connected-factory-master/Source_Code/Visual_Recognition/Images/White_Without_Scratch/pic_7539ce21-5394-4477-a6c9-f5aeb3b18424.jpg
