RadaanK/Fischertechnik_Factory_IBM/int-connected-factory-master/Source_Code/Visual_Recognition/Images/White_Without_Scratch/pic_ac94ee0f-0150-43ab-8d6e-e4895476c46d.jpg

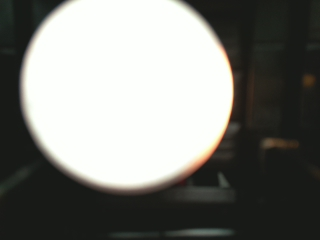
int-connected-factory-master/Source_Code/Visual_Recognition/Images/White_Without_Scratch/pic_ac94ee0f-0150-43ab-8d6e-e4895476c46d.jpg
