RadaanK/Fischertechnik_Factory_IBM/int-connected-factory-master/Source_Code/Visual_Recognition/Images/White_Without_Scratch/pic_b57f3f08-e151-4241-b2d1-9ef9095f02d4.jpg

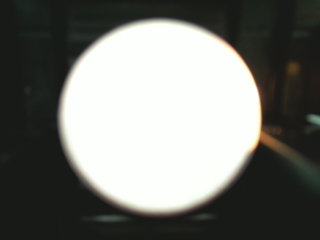
int-connected-factory-master/Source_Code/Visual_Recognition/Images/White_Without_Scratch/pic_b57f3f08-e151-4241-b2d1-9ef9095f02d4.jpg
