RadaanK/Fischertechnik_Factory_IBM/int-connected-factory-master/Source_Code/Visual_Recognition/Images/White_Without_Scratch/pic_c6e48539-5043-4157-9693-ad88b3b9c8fe.jpg

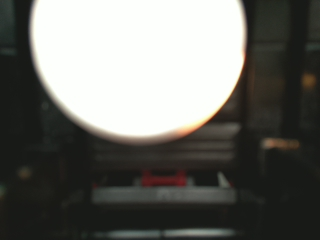
int-connected-factory-master/Source_Code/Visual_Recognition/Images/White_Without_Scratch/pic_c6e48539-5043-4157-9693-ad88b3b9c8fe.jpg
