RadaanK/Fischertechnik_Factory_IBM/int-connected-factory-master/Source_Code/Visual_Recognition/Images/White_Without_Scratch/pic_db3caff3-0209-48d3-88b7-45c64d8b854b.jpg

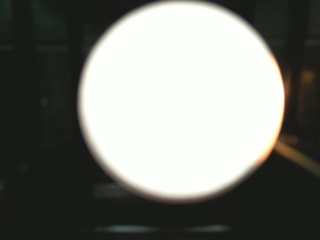
int-connected-factory-master/Source_Code/Visual_Recognition/Images/White_Without_Scratch/pic_db3caff3-0209-48d3-88b7-45c64d8b854b.jpg
