RadaanK/Fischertechnik_Factory_IBM/int-connected-factory-master/Source_Code/Visual_Recognition/Images/White_Without_Scratch/pic_e9c41447-2d69-43a0-9a93-c415fc0daa38.jpg

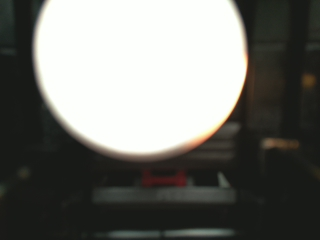
int-connected-factory-master/Source_Code/Visual_Recognition/Images/White_Without_Scratch/pic_e9c41447-2d69-43a0-9a93-c415fc0daa38.jpg
