RadaanK/Fischertechnik_Factory_IBM/int-connected-factory-master/Source_Code/Watson Assistant/Readme_Images/Chatbot_Dialog_Skill.png

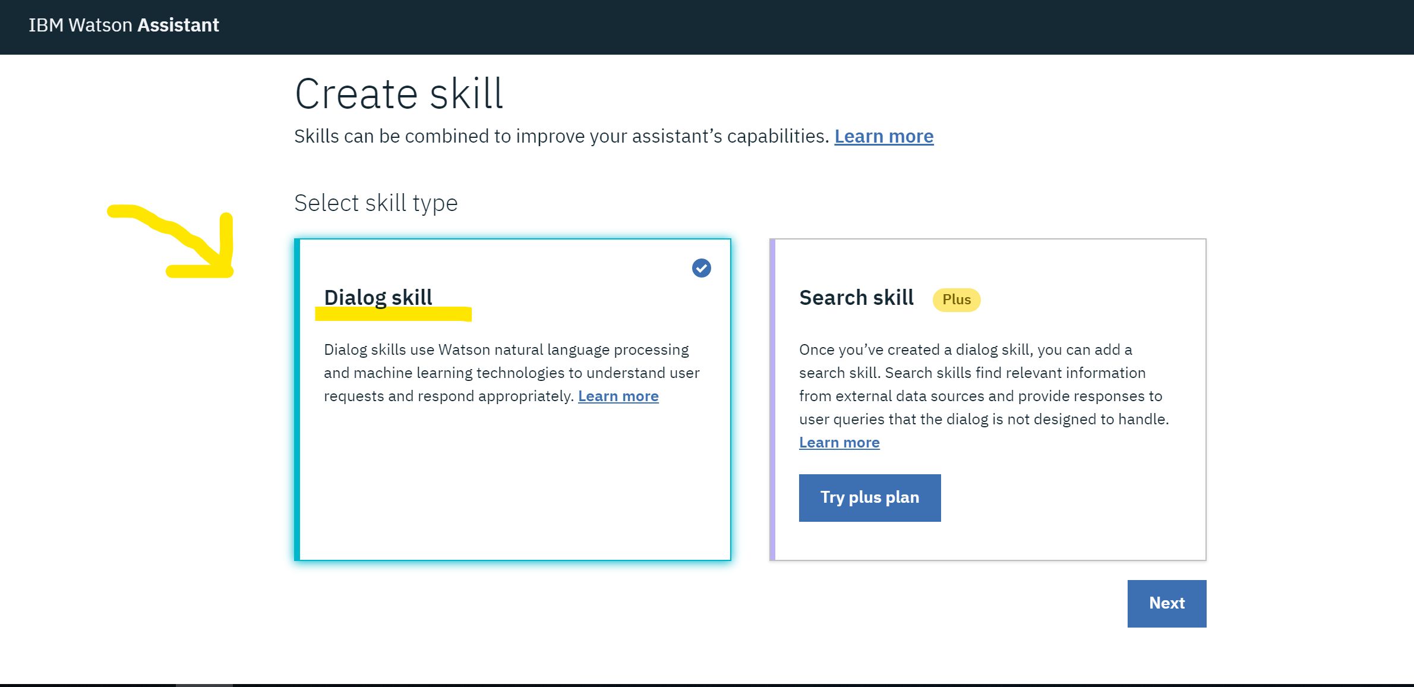
int-connected-factory-master/Source_Code/Watson Assistant/Readme_Images/Chatbot_Dialog_Skill.png
