RadaanK/Fischertechnik_Factory_IBM/int-connected-factory-master/Source_Code/Watson Assistant/Readme_Images/Chatbot_Import_Skill.png

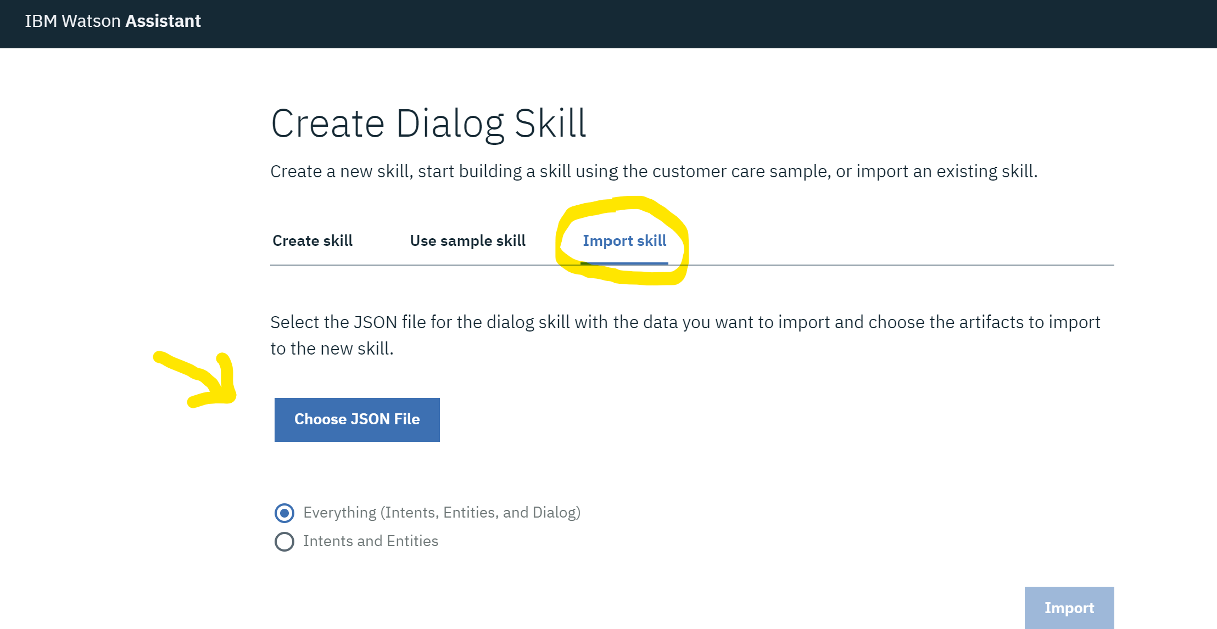
int-connected-factory-master/Source_Code/Watson Assistant/Readme_Images/Chatbot_Import_Skill.png
