RadaanK/Fischertechnik_Factory_IBM/int-connected-factory-master/Documents/List_of_Components/Bill_of_material.xlsx

Bill of Material
Product | Amount | Price per unit | Price | Explanation | Link
Fischertechnik Plant | 1 | 3927.00 € | 3927.00 € | Central element of the model factory | https://santjohanser.de/fischertechnik/simulieren/trainingsmodelle/1431/fabrik-simulation-9v-simulation
Vacuum Gripper | 1 | 870.00 € | 870.00 € | Additional module that was built-in (not included in the original model) | https://santjohanser.de/fischertechnik/simulieren/trainingsmodelle/1432/vakuum-sauggreifer-9v-simulation
Warehouse | 1 | 950.00 € | 950.00 € | Additional module that was built-in (not included in the original model) | https://santjohanser.de/fischertechnik/simulieren/trainingsmodelle/1435/automatisiertes-hochregallager-9v-simulation
Power Supply | 4 | 61.40 € | 245.60 € | Power supplies for the different modules | https://santjohanser.de/fischertechnik/einzelteile/elektronik/power/1207/schaltnetzgeraet-9v-2-5a-schwarz
Ardunio Unos | 3 | 18.70 € | 56.10 € | Take on the role as gateway | https://www.amazon.de/Arduino-Uno-Rev-3-Mikrocontroller-Board/dp/B008GRTSV6?adgrpid=67852988861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
Arduino Nano | 4 | 4.7 | 18.80 € | Take on the role as gateway | https://www.amazon.de/Elegoo-Entwicklerboard-Arduino-Atmega328P-CH340/dp/B0713ZRJLC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
Raspberry Pi | 3 | 34.80 € | 104.40 € | Used for Visual Inspection, Remote Control and Gateway | https://www.amazon.de/Raspberry-1373331-Pi-Modell-Mainboard/dp/B07BDR5PDW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
Power adapter for Pi | 3 | 11.00 € | 33.00 € | Power supply fo the Raspberry Pi | https://www.raspberrypi.org/products/raspberry-pi-universal-power-supply/
Raspberry Pi Camera | 2 | 24.50 € | 49.00 € | Camera for Visual Inspection and remote Control (connected to the Pi) | https://www.raspberrypi.org/products/camera-module-v2/
ESP 32 | 1 | 10.00 € | 10.00 € | Takes the role as gateway between Temp sensor and Rasp Pi | https://www.conrad.com/p/joy-it-development-board-node-mcu-esp32-modul-1656367
Power Strip | 1 | 15.00 € | 15.00 € | provides additional power plug slots | The amount depends on the number of ports available
Jumper wires | 1 | 7.00 € | 7.00 € | Used to connect the Arduinos/Esp32 and so on | https://www.amazon.de/Female-Female-Male-Female-Male-Male-Steckbr%C3%BCcken-Drahtbr%C3%BCcken-bunt/dp/B01EV70C78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
NFC Reader | 3 | 3.00 € | 9.00 € | Used to read the NFC tags | https://www.amazon.de/AZDelivery-Reader-Arduino-Raspberry-gratis/dp/B074S8MRQ7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
NFC Tags | 13 | 0.60 € | 7.80 € | one NFC tag is sticked to every workpiece | https://www.amazon.de/Sticker-selbstklebend-kompatibel-Leseger%C3%A4ten-Aufkleber-Wei%C3%9F/dp/B06XH2R5ZP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
Temp/Humidity Sensor | 1 | 7.50 € | 7.50 € | records the temperature, which is displayed in the dashboard | https://www.conrad.com/p/seeed-studio-temperature-humidity-sensor-sen-11301-p-suitable-for-series-c-control-duino-grove-1369549
Pressure Sensor | 1 | 22.50 € | 22.50 € | can detect if the vacuum gripper looses a workpiece | https://www.antratek.nl/mprls-ported-pressure-sensor-breakout-0-to-25-psi
USB A-B | 3 | 6.00 € | 18.00 € | Connection between the Rasberry pi an the Arduino Unos | https://www.amazon.de/AmazonBasics-USB-2-0-Druckerkabel-Stecker-B-Stecker/dp/B00NH144GK?hvadid=204420027984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
USB A-micro | 2 | 6.25 € | 12.50 € | Used to connect the raspberry pi | https://www.amazon.de/deleyCON-Ladekabel-Datenkabel-Smartphones-B-Stecker/dp/B00WHZ9BYM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
USB A-mini | 4 | 5.50 € | 22.00 € | Connection between the Rapsberry pi an the Arduino Nanos | https://www.amazon.de/AmazonBasics-IFRI-Stecker-Mini-B-Stecker-Schwarz/dp/B00NH13S44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
Powered Usb Hub | 1 | 18.00 € | 18.00 € | extend the usb ports of the Raspberry Pi | https://www.amazon.de/Anker-inkl-10W-Ladeger%C3%A4t-Datenhub-Ultrabooks/dp/B0192W3HX8
normal Usb Hub | 1 | 10.00 € | 10.00 € | extend the usb ports of the Raspberry Pi | https://www.amazon.de/Anker-Datenhub-Ultrabooks-weiteren-kompatiblen/dp/B00Y211AFM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
IoT Platform | 1 | 1.994,00 € EUR/Plan | 1994.00 € | Needed for interaction between Node-RED, Cloudant and Plant | https://www.ibm.com/internet-of-things/solutions/iot-platform/watson-iot-platform
Cloudant | 1 | lite should be ok (for free) | 0.00 € | Database needed to store sensor events which can then be queried | https://www.ibm.com/cloud/cloudant
Node-Red | 1 | 0,0558 € EUR/GB-Hour | 0.00 € | MES (controlls the plant) | https://cloud.ibm.com/catalog/starters/node-red-starter
Visual Recognition (Standard) | 1 | $0.002 / image classification | 0.00 € | Used for scratch detection on workpieces | https://www.ibm.com/watson/services/visual-recognition/pricing/index.html#pricing
 |  | $0.10 / image training
Watson Studio (Standard) | 1 | 78,97 € EUR/Instance | 157.94 € | Used to train the model for Visual Recognition | https://www.ibm.com/cloud/watson-studio
 |  | 0,40 € EUR/Capacity Unit Hour
 |  | 78,97 € EUR/Authorized User
Watson Assistant | 1 | 0,0025 $ USD/API call | 0.00 € | Chatbot/Interaction with the plant via Slack | https://www.ibm.com/cloud/watson-assistant/pricing/
Cloud Functions | 1 | should be for free | 0.00 € | Used to send commands to the plant and to query the database | https://cloud.ibm.com/functions/learn/pricing
Cloud Object Storage | 1 | should be for free | 0.00 € | Images used in the Node Red dashboard are stored here | https://www.ibm.com/cloud/object-storage
 |  | Total | 8565.14 €
