RadaanK/Fischertechnik_Factory_IBM/int-connected-factory-master/Documents/List_of_Components/List_of_Cloud_services_NEW.xlsx

 | List of Cloud Services
 | This Excel file lists all the needed Cloud services needed for the Fischertechnik Showcase.
 | Prices have been updated on the 18.10.2019 (dd.mm.yyyy)
 | Service | Price | Costs per Month (+-) | Comment | link
1 | IoT Platform | lite plan (free) | 0 € | Needed for interaction between Node-RED, Cloudant and Plant | https://www.ibm.com/internet-of-things/solutions/iot-platform/watson-iot-platform
2 | Cloudant | lite plan (for free) | 0 € | Database needed to store sensor events which can then be queried | https://www.ibm.com/cloud/cloudant
3 | Node-Red | 0,0558 € EUR/GB-Hour | 41€ (max) | MES (controlls the plant) | https://cloud.ibm.com/catalog/starters/node-red-starter
4 | Visual Recognition (Standard) | $0.002 / image classification |  | Used for scratch detection on workpieces | https://www.ibm.com/watson/services/visual-recognition/pricing/index.html#pricing
 |  | $0.10 / image training
5 | Watson Studio (Standard) | 78,97 € EUR/Instance |  | Used to train the model for Visual Recognition | https://www.ibm.com/cloud/watson-studio
 |  | 0,40 € EUR/Capacity Unit Hour
 |  | 78,97 € EUR/Authorized User
6 | Watson Assistant | 0,0025 $ USD/API call | 0,5€ (max) | Chatbot/Interaction with the plant via Slack | https://www.ibm.com/cloud/watson-assistant/pricing/
7 | Cloud Functions | should be for free | 0 € | Used to send commands to the plant and to query the database | https://cloud.ibm.com/functions/learn/pricing
8 | Cloud Object Storage | should be for free | 0 € | Images used in the Node Red dashboard are stored here | https://www.ibm.com/cloud/object-storage
