RadaanK/Fischertechnik_Factory_IBM/int-connected-factory-master/Documents/Module Events/Events_Warehouse_1.xlsx

events |  |  |  | commands
ID | Data | Event |  | ID | Data | command
2 | 1 | Start reference run |  | 2 | 1 | Store a piece in Position 1
2 | 2 | stop reference run |  | 2 | 2 | Store a piece in Position 2
2 | 3 |  |  | 2 | 3 | Store a piece in Position 3
2 | 4 |  |  | 2 | 4 | Store a piece in Position 4
2 | 5 |  |  | 2 | 5 | Store a piece in Position 5
2 | 6 |  |  | 2 | 6 | Store a piece in Position 6
2 | 7 |  |  | 2 | 7 | Store a piece in Position 7
2 | 8 |  |  | 2 | 8 | Store a piece in Position 8
2 | 9 |  |  | 2 | 9 | Store a piece in Position 9
2 | 10 |  |  | 2 | 10
2 | 11 | einlagern beginnen |  | 2 | 11 | Get a piece from Position 1
2 | 12 | einlagern beenden |  | 2 | 12 | Get a piece from Position 2
2 | 13 | fahre in x Richtung begonnen |  | 2 | 13 | Get a piece from Position 3
2 | 14 | fahre in x Richtung beendet |  | 2 | 14 | Get a piece from Position 4
2 | 15 | fahre in y Richtung begonnen |  | 2 | 15 | Get a piece from Position 5
2 | 16 | fahre in y richtung beendet |  | 2 | 16 | Get a piece from Position 6
2 | 17 | Z-Richtung einfahren begonnen |  | 2 | 17 | Get a piece from Position 7
2 | 18 | Z-Richtung einfahren beenden |  | 2 | 18 | Get a piece from Position 8
2 | 19 | Z-Richtung ausfahren begonnen |  | 2 | 19 | Get a piece from Position 9
2 | 20 | Z-Richtung ausfahren beenden |  | 2 | 20
2 | 21 | Aufnhemen am Regal beginnen |  | 2 | 21 | Werkstück wurde vom Kran geliefert
2 | 22 | Aufnehmen am Regal beenden |  | 2 | 22 | Werkstück wurde vom Kran aufgenommen
2 | 23 | Aufnehmen am Band beginnen
2 | 24 | Aufnehmen am Band beenden
2 | 25 | Absetzten am Regal beginnen
2 | 26 | Absetzten am Regal beenden
2 | 27 | Absetzten am Band beginnen
2 | 28 | Absetzten am Band beenden
2 | 29 | Ausgeben am Band beginnen
2 | 30 | Ausgeben am Band beenden | danach muss gewartet werden bis Werkstück vom Kran geliefert/aufgenommen wurde
2 | 31 | Zustellen am Band beginnen | kann erst beginnen nachdem Werkstück vom Kran losgelassen/aufgenommen wurde
2 | 32 | Zustellen am Band beenden
2 | 33 | Auslagern beginnen
2 | 34 | Auslagern beenden
2 | 35 | Bereit für Auftrag
2 | 36 | Auftrag beendet
2 | 37
2 | 38
2 | 39
2 | 40
2 | 41 | Inner Light barrier active
2 | 42 | Inner Light barrier not active
2 | 43 | Outer Light barrier active
2 | 44 | Outer Light barrier not active
2 | 45
2 | 46
2 | 47
2 | 48
2 | 49
2 | 50
2 | 51 | Fahre erste Reihe an
2 | 52 | Fahre zweite Reihe an
2 | 53 | Fahre dritte Reihe an
2 | 54 | Fahre zum Förderband (x_Richtung)
2 | 55
2 | 56 | Fahre erste Ebene an
2 | 57 | Fahre zweite Ebene an
2 | 58 | Fahre dritte Ebene an
2 | 59 | Fahre zum Förderband (y-Richtung)
2 | 60
