RadaanK/Fischertechnik_Factory_IBM/int-connected-factory-master/Documents/Module Events/Events_Warehouse_2.xlsx

events |  |  |  | commands
ID | Data | Event |  | ID | Data | command
7 | 1 | Start reference run |  | 7 | 1 | Store a piece in Position 1
7 | 2 | stop reference run |  | 7 | 2 | Store a piece in Position 2
7 | 3 |  |  | 7 | 3 | Store a piece in Position 3
7 | 4 |  |  | 7 | 4 | Store a piece in Position 4
7 | 5 |  |  | 7 | 5 | Store a piece in Position 5
7 | 6 |  |  | 7 | 6 | Store a piece in Position 6
7 | 7 |  |  | 7 | 7 | Store a piece in Position 7
7 | 8 |  |  | 7 | 8 | Store a piece in Position 8
7 | 9 |  |  | 7 | 9 | Store a piece in Position 9
7 | 10 |  |  | 7 | 10
7 | 11 | einlagern beginnen |  | 7 | 11 | Get a piece from Position 1
7 | 12 | einlagern beenden |  | 7 | 12 | Get a piece from Position 2
7 | 13 | fahre in x Richtung begonnen |  | 7 | 13 | Get a piece from Position 3
7 | 14 | fahre in x Richtung beendet |  | 7 | 14 | Get a piece from Position 4
7 | 15 | fahre in y Richtung begonnen |  | 7 | 15 | Get a piece from Position 5
7 | 16 | fahre in y richtung beendet |  | 7 | 16 | Get a piece from Position 6
7 | 17 | Z-Richtung einfahren begonnen |  | 7 | 17 | Get a piece from Position 7
7 | 18 | Z-Richtung einfahren beenden |  | 7 | 18 | Get a piece from Position 8
7 | 19 | Z-Richtung ausfahren begonnen |  | 7 | 19 | Get a piece from Position 9
7 | 20 | Z-Richtung ausfahren beenden |  | 7 | 20
7 | 21 | Aufnhemen beginnen |  | 7 | 21 | Werkstück wurde vom Kran geliefert
7 | 22 | Aufnehmen beenden |  | 7 | 22 | Werkstück wurde vom Kran aufgenommen
7 | 23 | Aufnehmen am Band beginnen
7 | 24 | Aufnehmen am Band beenden
7 | 25 | Absetzten beginnen
7 | 26 | Absetzten beenden
7 | 27 | Absetzten am Band beginnen
7 | 28 | Absetzten am Band beenden
7 | 29 | Ausgeben am Band beginnen
7 | 30 | Ausgeben am Band beenden | danach muss gewartet werden bis Werkstück vom Kran geliefert/aufgenommen wurde
7 | 31 | Zustellen am Band beginnen | kann erst beginnen nachdem Werkstück vom Kran losgelassen/aufgenommen wurde
7 | 32 | Zustellen am Band beenden
7 | 33 | Auslagern beginnen
7 | 34 | Auslagern beenden
7 | 35 | Bereit für Auftrag
7 | 36 | Auftrag beendet
7 | 37
7 | 38
7 | 39
7 | 40
7 | 41 | Inner Light barrier active
7 | 42 | Inner Light barrier not active
7 | 43 | Outer Light barrier active
7 | 44 | Outer Light barrier not active
7 | 45
7 | 46
7 | 47
7 | 48
7 | 49
7 | 50
7 | 51 | Fahre erste Reihe an
7 | 52 | Fahre zweite Reihe an
7 | 53 | Fahre dritte Reihe an
7 | 54 | Fahre zum Förderband (x_Richtung)
7 | 55
7 | 56 | Fahre erste Ebene an
7 | 57 | Fahre zweite Ebene an
7 | 58 | Fahre dritte Ebene an
7 | 59 | Fahre zum Förderband (y-Richtung)
