RadaanK/Fischertechnik_Factory_IBM/int-connected-factory-master/Documents/Documentation of the Setup/Read_Me.txt

This folder contains all the information about the setup.
Included is a ducumentation, where all the different parts are listed and their interaction are described.
