RadaanK/Fischertechnik_Factory_IBM/int-connected-factory-master/Source_Code/Node_RED_Cloud/Readme_Images/How_to_Import.png

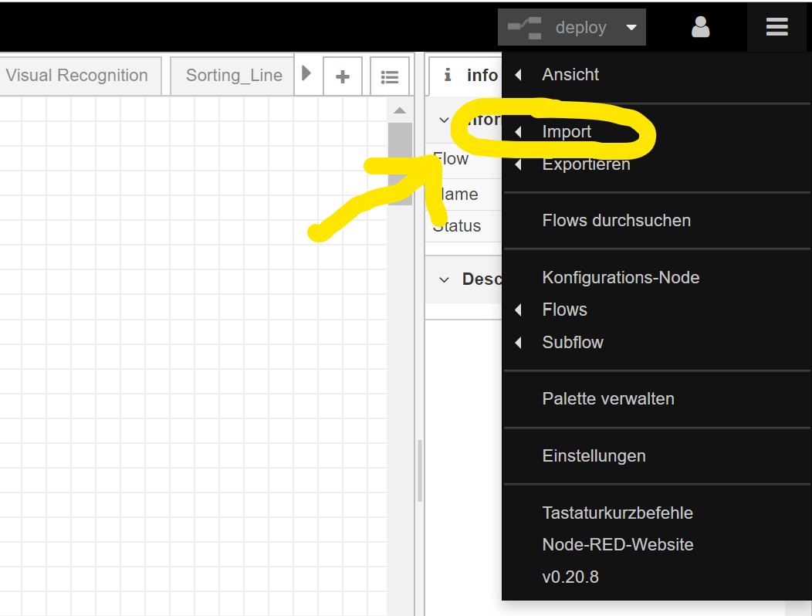
int-connected-factory-master/Source_Code/Node_RED_Cloud/Readme_Images/How_to_Import.png
