RadaanK/Fischertechnik_Factory_IBM/int-connected-factory-master/Documents/Architecture/Architecture.pdf

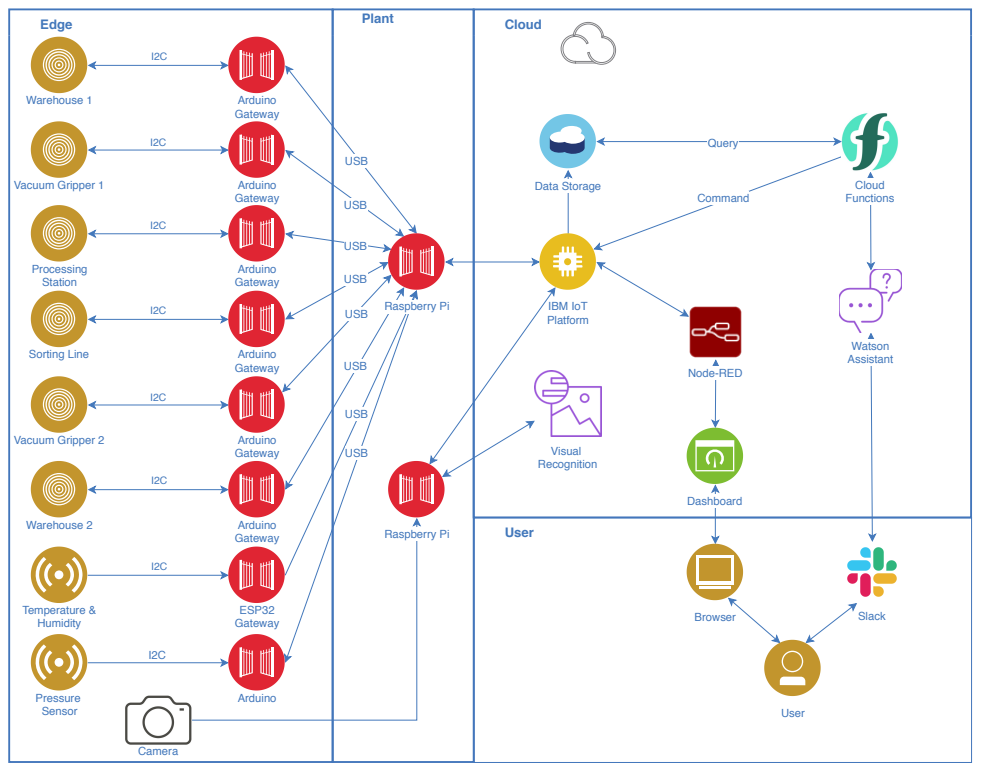
[picture p133: page 1]
USB; Warehouse 1; Vacuum Gripper 1; Processing Station; Sorting Line; Vacuum Gripper 2; Warehouse 2; Temperature & Humidity; Pressure Sensor; Arduino Gateway; Arduino; Gateway; ESP32 Gateway; Slack; Visual Recognition; Watson Assistant; Browser; User; Plant; Raspberry Pi; Cloud; Command; IBM IoT Platform; Data Storage; Functions; Query; Node-RED; Dashboard; Edge; Camera
